39394480ke-sys/serialstride-legbot/assets/images/stm32f103-blue-pill-bench.jpg

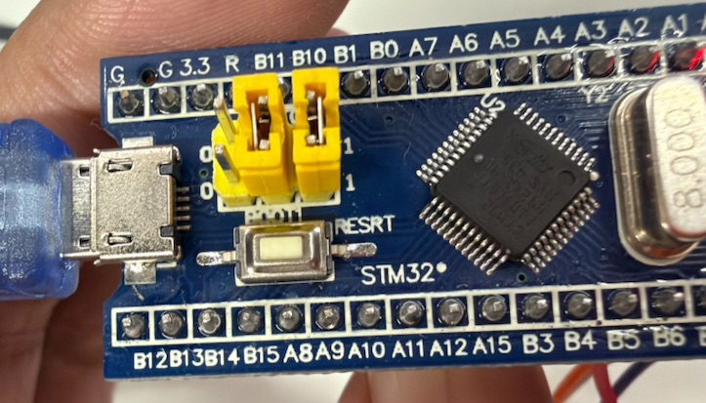
assets/images/stm32f103-blue-pill-bench.jpg
