39394480ke-sys/serialstride-legbot/项目记录/README.md

# 桌面级串联腿项目记录

这里保存桌面级串联腿底盘的阶段性结论、原始测试数据和可回退固件。
源代码只保存在 `../stm32f103_boot_test/`，本目录不复制源码。

## 当前状态

截至 2026-07-29，已完成一台 DM-H6215 的 STM32F103 临时台架验证：

- CAN 物理链路、1 Mbps 通信和双端 120 Ω 终端匹配正常。
- 参数读取、使能、失能、正反转和连续速度控制正常。
- 位置、速度、力矩、MOS 温度和线圈温度反馈解析正常。
- 速度斜坡、5 秒主机看门狗和异常自动失能正常。
- 当前可用固件已保存至 `固件快照/`。

## 目录

```text
项目记录/
├── README.md
├── 硬件接线与参数.md
├── 调试记录/
│   └── 2026-07-29_H6215单电机调通.md
├── 原始日志/
│   └── records-2026-07-29-21-30-49.json
└── 固件快照/
    ├── H6215_F103_连续速度控制_v1.bin
    └── SHA256SUMS
```

## 下一阶段

1. MC02 到货后迁移已经验证的 H6215 CAN 驱动和保护逻辑。
2. 增加第二台 H6215，设置不同 CAN ID，并验证左右轮同步和方向。
3. 完成 IMU 姿态读取和关节电机台架调试。
4. 在可靠支撑下测试 H6215 MIT 小力矩控制，为 LQR 平衡控制做准备。
