39394480ke-sys/serialstride-legbot/docs/progress/2026-08-14_MuJoCo三层模型职责重构.md

# 2026-08-14 MuJoCo 三层模型职责重构

## 阶段目标

固化整车 MuJoCo 模型中 CAD source、权威 geometry 与派生 dynamics 的职责
边界，避免后续动力学生成器重复创建或覆盖机构语义。

## 三层职责

| 模型 | 职责 | 状态 |
| --- | --- | --- |
| `robot_source.xml` | CAD 原始导出档案 | 内容未变化，SHA-256 已锁定 |
| `robot_geometry.xml` | 闭链、坐标、范围、传感器、模态接口和调试姿态 | 当前权威 geometry |
| `robot_dynamics.xml` | geometry 派生的质量与动力学模型 | 保留 Phase 1-3 快照，生成器待迁移 |

旧兼容入口 `robot.xml` 已删除。Phase 0 冻结记录继续保存在
`results/geometry_baseline.json`，当前权威记录为
`results/geometry_authority.json`。

## 验证结果

```text
robot_source.xml SHA-256:
9387924d3dad5ea2097e8953228b8de0cfd61661b36b10f039596c25b4e14d55

robot_geometry.xml SHA-256:
e7e1f21c22bbcc8846be8548e071819e72ccfad49df203704b56205417b800ea

robot_dynamics.xml SHA-256:
1bcb915f6203a42c6d35ebf9ee49d81685fd4969d9306a6783d7a1b5ae72ac21
```

权威 geometry 包含：

- 25 个 body；
- 24 个 joint；
- 6 个 equality connect；
- 4 个 fixed tendon；
- 4 个模态 position actuator；
- 11 个 keyframe。

11 个 keyframe 的最大闭链残差约为 `1.43e-9 m`。四个 rotation/shape
滑块的目标跟踪和左右腿隔离验证通过。用户已在 MuJoCo Viewer 中人工检查姿态
与滑块效果。

机械机构支持连续无限 360 度旋转，该能力已经由用户在实物机构上验证；
MuJoCo 全旋转扫描同时验证了数字模型的运动学与约束。

## 迁移保护

旧 `scripts/sync_inertials.py` 尚不理解新的模态 tendon、11 个 keyframe 和
气弹簧 slide 归一化。普通模式与 `--check` 均会在写文件前以
`MIGRATION REQUIRED` 停止，保护当前 dynamics 快照不被覆盖。

## 后续工作

- 迁移 geometry-to-dynamics 生成器；
- 恢复可重复的生成与一致性检查；
- 在 dynamics 中加入 6 个力矩电机、阻尼、摩擦、armature、气弹簧力、重力和场景；
- 后续验证地面接触、承重站立与控制算法。

## 验证命令

```sh
python3 simulation/mujoco/full_chassis/validate_model.py
python3 -m unittest discover \
  -s simulation/mujoco/full_chassis/scripts \
  -p 'test_*.py'
```
