39394480ke-sys/serialstride-legbot/docs/superpowers/plans/2026-08-08-dm-mc02-h6215-phase2.2a.md

# DM-MC02 + H6215 Phase 2.2a Implementation Plan

> **For agentic workers:** REQUIRED SUB-SKILL: Use superpowers:subagent-driven-development (recommended) or superpowers:executing-plans to implement this plan task-by-task. Steps use checkbox (`- [ ]`) syntax for tracking.

**Goal:** Add a USB CDC-triggered, one-shot `+0.2 rad/s` H6215 test that requires `A` then `G`, runs for 1000 ms, holds zero for 200 ms, and always finishes disabled.

**Architecture:** Keep CAN frame encoding, motion policy, and USB byte buffering in separate host-testable modules. `main.c` remains the hardware orchestrator: it converts feedback and CAN health into a safety snapshot, consumes USB commands, executes requested CAN actions, and emits logs. The first hardware session validates `S/A/X` without motion; only a later explicit user `G` starts the positive pulse.

**Tech Stack:** C11 host tests, STM32H723 HAL/FDCAN, ST USB Device CDC, CMake/Ninja, STM32CubeIDE GNU Arm toolchain, STM32CubeProgrammer CLI.

## Global Constraints

- Default state after reset or power-up is disabled; reset must never start motion.
- USB commands are single ASCII bytes, case-insensitive; CR and LF are ignored.
- `A` arms for exactly 10,000 ms and authorizes at most one `G`.
- `G` is the only Phase 2.2a motion trigger; `B` and continuous-speed commands remain unavailable.
- Target speed is fixed at `+0.200 rad/s` for 1000 ms, followed by `0 rad/s` for 200 ms and Disable.
- Speed commands are refreshed every 10 ms while running or holding zero.
- Start limits: fresh feedback within 500 ms, `STATE=DISABLED`, `MODE=3`, `|V|<0.1 rad/s`, both temperatures below 60 C, and CAN free of warning/passive/bus-off.
- Runtime limits: fresh feedback within 100 ms, `STATE=ENABLED`, `|V|<=0.8 rad/s`, both temperatures below 60 C, and CAN free of passive/bus-off.
- `X` always requests zero speed followed by Disable and clears Arm.
- No motor register writes, position commands, torque commands, DM4310 work, or GitHub push are part of this plan.

---

### Task 1: Encode the Guarded Motion CAN Frames

**Files:**
- Modify: `firmware/dm-mc02-can1-three-motor/app/h6215_protocol.h`
- Modify: `firmware/dm-mc02-can1-three-motor/app/h6215_protocol.c`
- Modify: `firmware/dm-mc02-can1-three-motor/tests/test_h6215_protocol.c`

**Interfaces:**
- Consumes: existing `H6215CanFrame`, `H6215_CAN_ID=1`.
- Produces: `bool h6215_build_enable_command(H6215CanFrame *frame)`, `bool h6215_build_positive_velocity_command(H6215CanFrame *frame)`, and `bool h6215_build_zero_velocity_command(H6215CanFrame *frame)`.

- [ ] **Step 1: Write failing frame-encoding tests**

Add tests asserting the exact verified protocol bytes:

```c
static void test_builds_enable_command(void)
{
    H6215CanFrame frame = {0};
    assert(h6215_build_enable_command(&frame));
    assert(frame.id == 1u && frame.dlc == 8u);
    for (uint8_t i = 0u; i < 7u; ++i) assert(frame.data[i] == 0xffu);
    assert(frame.data[7] == 0xfcu);
}

static void test_builds_phase22a_velocity_commands(void)
{
    H6215CanFrame frame = {0};
    assert(h6215_build_positive_velocity_command(&frame));
    assert(frame.id == 0x201u && frame.dlc == 4u);
    assert(frame.data[0] == 0xcdu && frame.data[1] == 0xccu);
    assert(frame.data[2] == 0x4cu && frame.data[3] == 0x3eu);

    assert(h6215_build_zero_velocity_command(&frame));
    assert(frame.id == 0x201u && frame.dlc == 4u);
    assert(frame.data[0] == 0u && frame.data[1] == 0u);
    assert(frame.data[2] == 0u && frame.data[3] == 0u);
}
```

- [ ] **Step 2: Run tests and verify RED**

Run: `cd firmware/dm-mc02-can1-three-motor && tests/run_tests.sh`

Expected: linker failure for the three missing `h6215_build_*` functions.

- [ ] **Step 3: Implement only the three fixed commands**

Use a private helper for the two system frames and fixed IEEE-754 bytes for `+0.2f`. Zero every unused data byte even though the velocity DLC is 4.

```c
static bool build_system_command(uint8_t opcode, H6215CanFrame *frame);

bool h6215_build_enable_command(H6215CanFrame *frame)
{
    return build_system_command(0xfcu, frame);
}

bool h6215_build_positive_velocity_command(H6215CanFrame *frame)
{
    static const uint8_t value[4] = {0xcdu, 0xccu, 0x4cu, 0x3eu};
    /* CAN ID 0x200 + motor ID 1, classic CAN, four-byte payload. */
}
```

- [ ] **Step 4: Run all host tests and verify GREEN**

Run: `tests/run_tests.sh`

Expected: exit 0 with no warnings.

- [ ] **Step 5: Commit the protocol change**

```bash
git add firmware/dm-mc02-can1-three-motor/app/h6215_protocol.* \
        firmware/dm-mc02-can1-three-motor/tests/test_h6215_protocol.c
git commit -m "feat: encode guarded H6215 motion frames"
```

---

### Task 2: Build a Pure Guarded Motion State Machine

**Files:**
- Create: `firmware/dm-mc02-can1-three-motor/app/motion_controller.h`
- Create: `firmware/dm-mc02-can1-three-motor/app/motion_controller.c`
- Create: `firmware/dm-mc02-can1-three-motor/tests/test_motion_controller.c`
- Modify: `firmware/dm-mc02-can1-three-motor/tests/run_tests.sh`

**Interfaces:**
- Consumes: a caller-provided `MotionSafetySnapshot`; no HAL, USB, or FDCAN headers.
- Produces:

```c
typedef enum {
    MOTION_IDLE_DISABLED,
    MOTION_ARMED,
    MOTION_ENABLE_WAIT,
    MOTION_RUNNING,
    MOTION_ZERO_HOLD,
    MOTION_FAULT_ZERO,
    MOTION_FAULT_DISABLE
} MotionState;

typedef enum {
    MOTION_ACTION_NONE,
    MOTION_ACTION_ENABLE,
    MOTION_ACTION_POSITIVE_VELOCITY,
    MOTION_ACTION_ZERO_VELOCITY,
    MOTION_ACTION_DISABLE
} MotionAction;

typedef enum {
    MOTION_EVENT_NONE,
    MOTION_EVENT_STATUS,
    MOTION_EVENT_ARMED,
    MOTION_EVENT_ARM_TIMEOUT,
    MOTION_EVENT_START_REJECTED,
    MOTION_EVENT_START_REQUESTED,
    MOTION_EVENT_RUNNING,
    MOTION_EVENT_ZERO_HOLD,
    MOTION_EVENT_COMPLETE,
    MOTION_EVENT_EMERGENCY_STOP,
    MOTION_EVENT_SAFETY_TRIP,
    MOTION_EVENT_TX_FAILURE
} MotionEvent;

typedef struct {
    uint32_t now_ms;
    uint32_t feedback_age_ms;
    uint8_t parameter_mask;
    uint8_t control_mode;
    uint8_t motor_state;
    int32_t velocity_millirad_s;
    uint8_t mos_temperature_c;
    uint8_t rotor_temperature_c;
    bool feedback_valid;
    bool can_warning;
    bool can_passive;
    bool can_bus_off;
} MotionSafetySnapshot;

typedef struct {
    MotionAction action;
    MotionEvent event;
    const char *reason;
} MotionDecision;

typedef struct {
    MotionState state;
    bool armed;
    uint32_t armed_at_ms;
    uint32_t phase_started_ms;
    uint32_t last_action_ms;
} MotionController;

void motion_controller_init(MotionController *controller);
MotionDecision motion_controller_command(MotionController *controller,
                                          uint8_t command,
                                          const MotionSafetySnapshot *safety);
MotionDecision motion_controller_step(MotionController *controller,
                                       const MotionSafetySnapshot *safety);
MotionDecision motion_controller_tx_failed(MotionController *controller);
```

- [ ] **Step 1: Write failing tests for command gating**

Cover lowercase/uppercase, ignored CR/LF, `G` without Arm, Arm validity at 9,999 ms and timeout at 10,000 ms, one-shot Arm consumption, unsafe mode/state/speed/temperature/CAN rejection, and `X` from every state. Representative assertion:

```c
MotionSafetySnapshot safe = safe_disabled_snapshot(1000u);
MotionController controller;
motion_controller_init(&controller);

MotionDecision arm = motion_controller_command(&controller, 'A', &safe);
assert(arm.event == MOTION_EVENT_ARMED);
MotionDecision start = motion_controller_command(&controller, 'g', &safe);
assert(start.action == MOTION_ACTION_ENABLE);
assert(controller.state == MOTION_ENABLE_WAIT);
assert(!controller.armed);
```

- [ ] **Step 2: Run the dedicated test and verify RED**

Add a third compiler invocation to `tests/run_tests.sh`, then run it.

Expected: compile failure because `motion_controller.h` and implementation do not exist.

- [ ] **Step 3: Implement command normalization and start checks**

Implement `S/A/G/X`, ignore `\r` and `\n`, and return a stable reason string such as `SEND_A_FIRST`, `MODE_NOT_VELOCITY`, `FEEDBACK_STALE`, `STATE_NOT_DISABLED`, `SPEED_NOT_ZERO`, `TEMPERATURE_LIMIT`, or `CAN_NOT_ACTIVE`.

- [ ] **Step 4: Run tests and verify command gating GREEN**

Run: `tests/run_tests.sh`

Expected: all existing and new gating tests pass.

- [ ] **Step 5: Write failing timeline and safety-trip tests**

Drive synthetic timestamps through this exact sequence:

```text
t=0       A then G -> ENABLE
t=100     feedback ENABLED -> +0.2 command and RUNNING
t=110..1090 every 10 ms -> +0.2 refresh
t=1100    -> zero command and ZERO_HOLD
t=1110..1290 every 10 ms -> zero refresh
t=1300    -> Disable and IDLE_DISABLED
```

Also assert feedback age 101 ms, speed 801 mrad/s, temperature 60 C, state change away from ENABLED, CAN passive, CAN bus-off, and transmit failure all enter zero-then-disable shutdown.

- [ ] **Step 6: Run timeline tests and verify RED**

Expected: failures because `motion_controller_step` does not yet implement timed transitions and trips.

- [ ] **Step 7: Implement timed transitions and fault shutdown**

Use unsigned tick subtraction for wraparound. `MOTION_FAULT_ZERO` must return one zero action, then `MOTION_FAULT_DISABLE` must return Disable on the next 1 ms step. Do not add negative or continuous states.

- [ ] **Step 8: Run all tests and verify GREEN**

Run: `tests/run_tests.sh`

Expected: all tests pass with `-Wall -Wextra -Werror`.

- [ ] **Step 9: Commit the state machine**

```bash
git add firmware/dm-mc02-can1-three-motor/app/motion_controller.* \
        firmware/dm-mc02-can1-three-motor/tests/test_motion_controller.c \
        firmware/dm-mc02-can1-three-motor/tests/run_tests.sh
git commit -m "feat: add guarded positive motion state machine"
```

---

### Task 3: Add a Nonblocking USB CDC Command Queue

**Files:**
- Create: `firmware/dm-mc02-can1-three-motor/app/usb_command_queue.h`
- Create: `firmware/dm-mc02-can1-three-motor/app/usb_command_queue.c`
- Create: `firmware/dm-mc02-can1-three-motor/tests/test_usb_command_queue.c`
- Modify: `firmware/dm-mc02-can1-three-motor/tests/run_tests.sh`
- Modify: `firmware/dm-mc02-can1-three-motor/CMakeLists.txt`
- Modify: `firmware/dm-mc02-can1-three-motor/platform/usb_device/App/usbd_cdc_if.c:24-35,264-270`
- Modify: `firmware/dm-mc02-can1-three-motor/platform/usb_device/App/usbd_cdc_if.h:32-55,108-112`

**Interfaces:**
- Consumes: byte spans received by `CDC_Receive_HS`.
- Produces:

```c
void usb_command_queue_init(void);
void usb_command_queue_push_from_isr(const uint8_t *data, uint32_t length);
bool usb_command_queue_pop(uint8_t *command);
uint32_t usb_command_queue_dropped(void);
```

- [ ] **Step 1: Write failing SPSC queue tests**

Test FIFO order, a packet containing `"A\r\nG"`, wraparound, null arguments, and deterministic drop-newest behavior when the fixed 32-byte queue is full.

- [ ] **Step 2: Run tests and verify RED**

Expected: missing header/implementation failure.

- [ ] **Step 3: Implement the 32-byte single-producer/single-consumer queue**

Use volatile byte indices. The USB callback is the only producer and the 1 ms main loop is the only consumer. Do not allocate memory, print, parse commands, or touch CAN inside the callback.

- [ ] **Step 4: Run queue tests and verify GREEN**

Run: `tests/run_tests.sh`

Expected: all tests pass.

- [ ] **Step 5: Wire only byte ingestion into `CDC_Receive_HS`**

The callback body must remain bounded:

```c
usb_command_queue_push_from_isr(Buf, *Len);
USBD_CDC_SetRxBuffer(&hUsbDeviceHS, &Buf[0]);
USBD_CDC_ReceivePacket(&hUsbDeviceHS);
return USBD_OK;
```

- [ ] **Step 6: Cross-compile the firmware**

Add `app/usb_command_queue.c` to `add_executable`, then run from the firmware directory:

```bash
cmake -S . -B build-phase22a -G Ninja
cmake --build build-phase22a
```

Expected: successful link with no warnings.

- [ ] **Step 7: Commit the USB queue**

```bash
git add firmware/dm-mc02-can1-three-motor/app/usb_command_queue.* \
        firmware/dm-mc02-can1-three-motor/tests/test_usb_command_queue.c \
        firmware/dm-mc02-can1-three-motor/tests/run_tests.sh \
        firmware/dm-mc02-can1-three-motor/CMakeLists.txt \
        firmware/dm-mc02-can1-three-motor/platform/usb_device/App/usbd_cdc_if.*
git commit -m "feat: receive guarded commands over USB CDC"
```

---

### Task 4: Integrate Motion Without Expanding `main.c` Policy

**Files:**
- Modify: `firmware/dm-mc02-can1-three-motor/app/main.c`
- Modify: `firmware/dm-mc02-can1-three-motor/CMakeLists.txt`
- Modify: `firmware/dm-mc02-can1-three-motor/platform/src/board.c:148-168`
- Modify: `firmware/dm-mc02-can1-three-motor/README.md`

**Interfaces:**
- Consumes: `usb_command_queue_pop`, `MotionSafetySnapshot`, `MotionDecision`, and the four H6215 action builders.
- Produces: hardware execution and the exact user-visible transition logs from the design.

- [ ] **Step 1: Add new modules to CMake and create a clean build directory**

Run:

```bash
cmake -S firmware/dm-mc02-can1-three-motor \
      -B firmware/dm-mc02-can1-three-motor/build-phase22a -G Ninja
```

Add `app/motion_controller.c` to `add_executable`; Task 3 already added `app/usb_command_queue.c`.

- [ ] **Step 2: Build the hardware safety snapshot in `main.c`**

Map the current `WheelStatus` and `Can1Status` into `MotionSafetySnapshot` once per 1 ms iteration. Feedback age must use the last actual feedback timestamp, not the last parameter response timestamp; split `last_rx_ms` into `last_any_rx_ms` and `last_feedback_ms`.

- [ ] **Step 3: Permit the approved four-byte classic CAN payload**

Update `board_can1_transmit` to accept only DLC 4 or 8 and map them explicitly:

```c
if (dlc == 4u) {
    header.DataLength = FDCAN_DLC_BYTES_4;
} else if (dlc == 8u) {
    header.DataLength = FDCAN_DLC_BYTES_8;
} else {
    return false;
}
```

Retain the existing standard-ID, null-pointer, FIFO-space, classic-CAN, and no-BRS checks. This is required because the H6215 velocity command has DLC 4 while the parameter/system frames have DLC 8.

- [ ] **Step 4: Add one action executor**

```c
static bool execute_motion_action(MotionAction action, WheelStatus *wheel)
{
    H6215CanFrame frame;
    /* Select exactly one approved builder, then call board_can1_transmit. */
}
```

On failure, immediately feed `motion_controller_tx_failed` back into the controller and execute its zero/Disable recovery sequence. Count every attempted result in `tx_ok` or `tx_failed`.

- [ ] **Step 5: Consume commands and step motion in the 1 ms loop**

Drain at most 32 queued bytes per loop. Process `X` before scheduled motion actions when both occur in the same millisecond. Parameter polling may continue while idle, but pause register polling during `ENABLE_WAIT`, `RUNNING`, `ZERO_HOLD`, and fault shutdown so it cannot contend with 10 ms control frames.

- [ ] **Step 6: Add nonblocking event logs**

Map events/actions to the design's exact stable strings: `MOTION_ARMED EXPIRES_MS=10000`, `MOTION_START_REQUESTED TARGET=+0.200rad/s`, `MOTOR_ENABLE_TX_OK`, `MOTION_RUNNING TARGET=+0.200rad/s DURATION_MS=1000`, `ZERO_SPEED_HOLD DURATION_MS=200`, and `TEST_COMPLETE MOTOR_DISABLED`. Rejections and trips append `REASON=<stable reason>`. Use static double buffers with `CDC_Transmit_HS`; a busy CDC endpoint increments `dropped_logs` and never blocks motion. During non-idle motion states, emit `[WHEEL]` every 100 ms; otherwise retain the 1000 ms rate.

- [ ] **Step 7: Update the boot banner and README**

Boot text must state:

```text
H6215_GUARDED_MOTION COMMANDS=S,A,G,X TARGET=+0.200rad/s
DEFAULT_STATE=DISABLED AUTO_MOTION=OFF
```

Document the exact serial.baud-dance.com settings and warn that `G` without a fresh `A` is rejected.

- [ ] **Step 8: Run host tests, clean build, and source audit**

Run:

```bash
tests/run_tests.sh
cmake --build build-phase22a
rg -n -- "-0\.2|MOTION_CONTINUOUS|0x300u|torque.*command" app platform
git diff --check
```

Expected: tests/build/diff pass; the audit finds no negative, continuous, force-position, or torque command implementation.

- [ ] **Step 9: Commit integration**

```bash
git add firmware/dm-mc02-can1-three-motor/app/main.c \
        firmware/dm-mc02-can1-three-motor/CMakeLists.txt \
        firmware/dm-mc02-can1-three-motor/platform/src/board.c \
        firmware/dm-mc02-can1-three-motor/README.md
git commit -m "feat: integrate guarded H6215 USB motion test"
```

---

### Task 5: Flash and Validate Commands Without Motion

**Files:**
- Generated only: `firmware/dm-mc02-can1-three-motor/build-phase22a/dm_mc02_phase1.bin`
- Evidence later written by Task 6; do not modify source during this checkpoint.

**Interfaces:**
- Consumes: ST-Link, powered MC02, connected H6215, USB CDC.
- Produces: proof that boot, `S`, `A` timeout, rejected `G`, and `X` remain non-moving and disabled.

- [ ] **Step 1: Reconfirm physical setup**

Require fixed stator, unobstructed rotor, 24 V cutoff within reach, CAN still connected, and serial tool automatic/loop sending disabled.

- [ ] **Step 2: Flash and verify**

Use STM32CubeProgrammer CLI with SWD under-reset connection, write the binary to `0x08000000`, enable verify, and reset. Record the binary SHA-256.

- [ ] **Step 3: Capture boot and idle state**

Require all boot markers, `[WHEEL] ONLINE=1`, `STATE=DISABLED`, `MODE=3`, `TEC=REC=0`, and `missed=0` before accepting commands.

- [ ] **Step 4: Verify `G` is rejected without Arm**

Send ASCII `G`. Require `START_REJECTED REASON=SEND_A_FIRST`, no Enable log, and continued `STATE=DISABLED`.

- [ ] **Step 5: Verify Arm timeout**

Send `A`; require `MOTION_ARMED EXPIRES_MS=10000`. Wait over 10 seconds; require `ARM_TIMEOUT`, then send `G` and require rejection with no movement.

- [ ] **Step 6: Verify `X` while idle**

Send `X`; require `EMERGENCY_STOP_REQUESTED`, a zero/Disable sequence, fresh `STATE=DISABLED` feedback, and no CAN errors.

- [ ] **Step 7: Stop at the human gate**

Report the idle-command evidence. Do not send `A` followed by `G`; the user must explicitly confirm readiness for the real positive test.

---

### Task 6: Execute and Archive the User-Triggered Positive Test

**Files:**
- Modify: `docs/bring-up/dm-mc02/README.md`
- Create: `docs/bring-up/dm-mc02/logs/phase2.2a-h6215-positive-2026-08-08.log.gz`
- Create: `docs/bring-up/dm-mc02/logs/phase2.2a-h6215-positive-2026-08-08.json`

**Interfaces:**
- Consumes: the user operating serial.baud-dance.com and the firmware from Task 5.
- Produces: reproducible evidence or a precise failed/aborted result without proceeding to negative motion.

- [ ] **Step 1: Give the user exact serial-tool settings**

Repeat `115200, 8 data bits, None parity, 1 stop bit, ASCII send/receive, HEX off, loop/automatic send off`. Select `STM32 Virtual ComPort (cu.usbmodem...)`.

- [ ] **Step 2: Capture the browser log and perform the human-triggered sequence**

Do not open the same USB serial port from a terminal while `serial.baud-dance.com` owns it. The user clears the browser receive pane, sends `S`, confirms safe idle output, sends `A`, waits for `MOTION_ARMED`, then sends `G`, and exports the browser's raw receive log after the observation window. Keep the 24 V cutoff within reach and use it immediately for unexpected direction, sustained motion beyond about one second, unusual sound, or mechanical interference.

- [ ] **Step 3: Validate automatic completion**

Require `MOTION_RUNNING`, `ZERO_SPEED_HOLD`, and `TEST_COMPLETE MOTOR_DISABLED`. Continue observing at least five seconds; require `STATE=DISABLED`, near-zero velocity, temperatures below 60 C, `TEC=REC=0`, no passive/bus-off, and `missed=0`.

- [ ] **Step 4: Compare observed behavior with logs**

Record the user's explicit direction observation separately from firmware facts. Compute minimum/maximum feedback velocity, position delta, torque range, temperature maxima, motion duration, and final CAN state from the captured log.

- [ ] **Step 5: Archive evidence and update documentation**

The JSON must distinguish verified telemetry, user-observed direction, inference, and unverified items. Compress the raw log with deterministic `gzip -n`, record raw log and firmware SHA-256, and state that negative/continuous motion remain unverified.

- [ ] **Step 6: Final verification without entering Phase 2.2b**

Run host tests, rebuild cleanly, validate JSON, test gzip integrity, run `git diff --check`, and sample current live `STATE=DISABLED`/CAN health. Do not add or execute `B` until the positive-test evidence has been reviewed.
