39394480ke-sys/serialstride-legbot/simulation/mujoco/full_chassis/meshes/link_004.stl

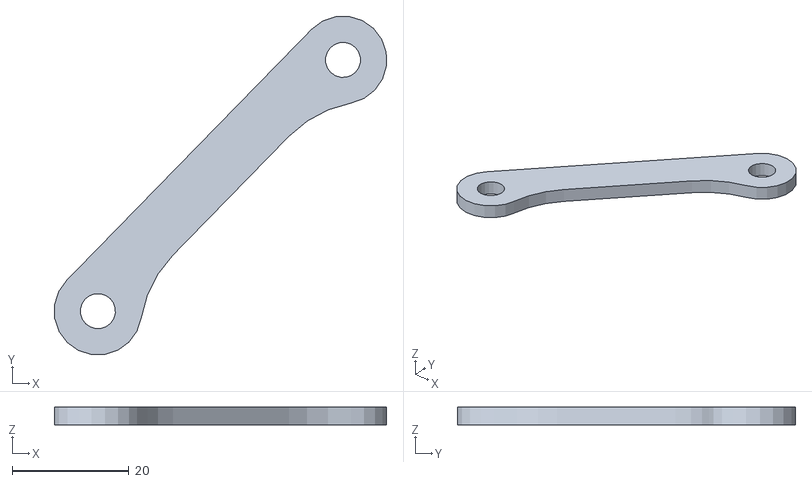
[picture p2: CAD file, 2026-08-13]
simulation/mujoco/full_chassis/meshes/link_004.stl
56.8 x 57.8 x 3.00
