39394480ke-sys/serialstride-legbot/simulation/mujoco/full_chassis/meshes/link_003.stl

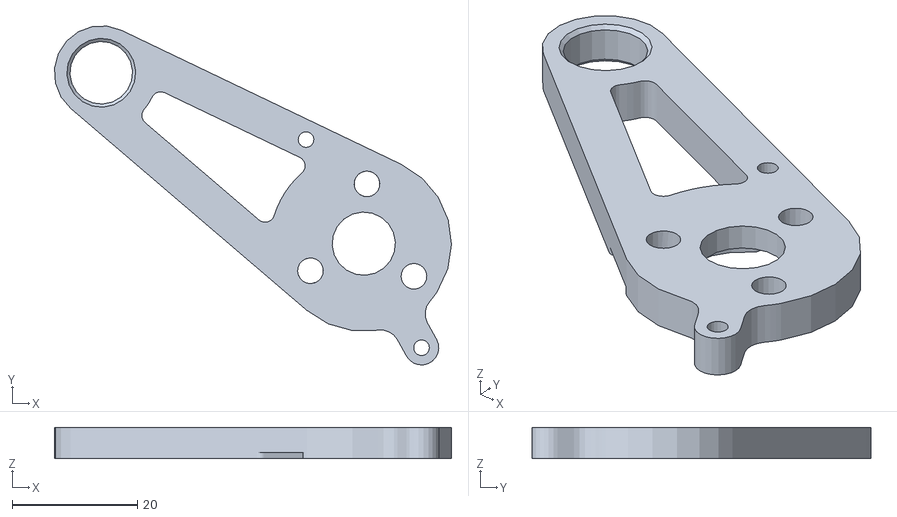
[picture p3: CAD file, 2026-08-13]
simulation/mujoco/full_chassis/meshes/link_003.stl
63.4 x 54.1 x 5.00
