39394480ke-sys/serialstride-legbot/simulation/mujoco/full_chassis/meshes/link_006.stl

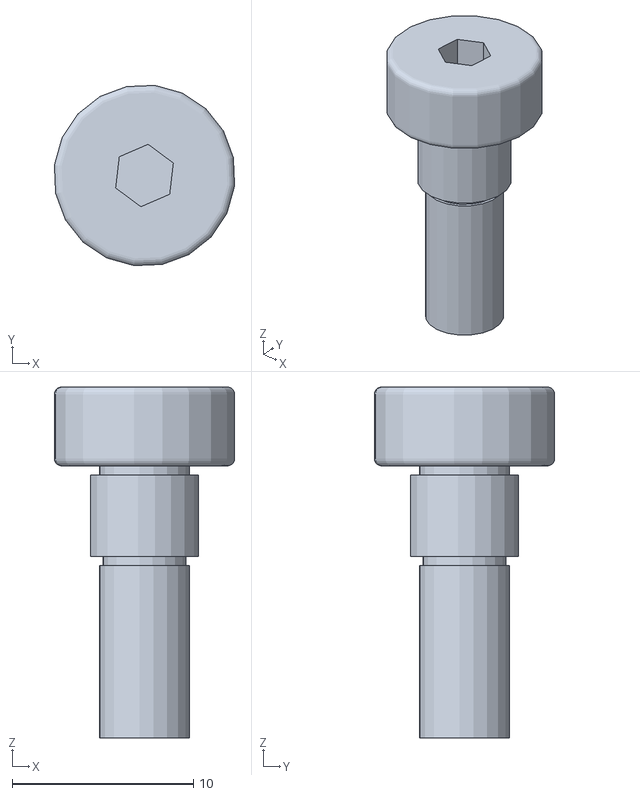
[picture p4: CAD file, 2026-08-13]
simulation/mujoco/full_chassis/meshes/link_006.stl
9.93 x 9.93 x 19.3
