39394480ke-sys/serialstride-legbot/simulation/mujoco/full_chassis/meshes/link_017.stl

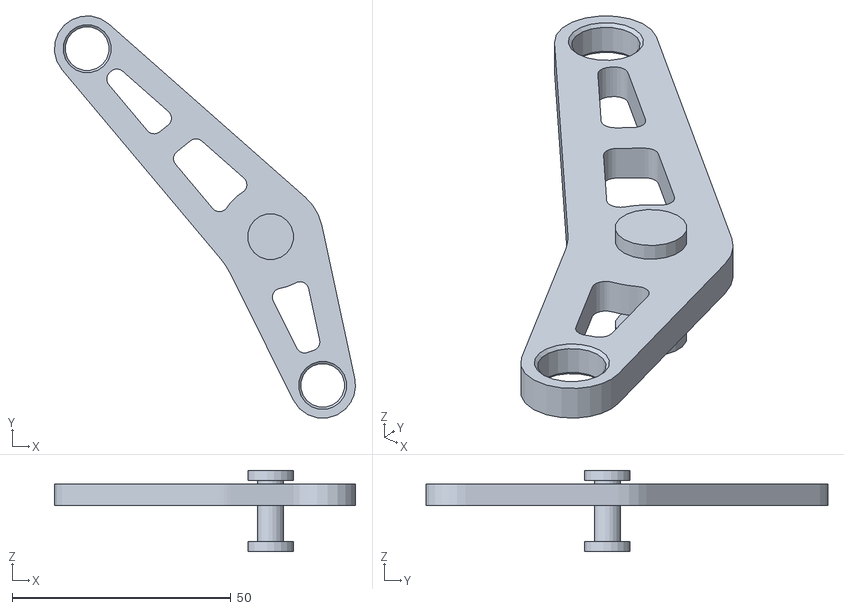
[picture p5: CAD file, 2026-08-13]
simulation/mujoco/full_chassis/meshes/link_017.stl
68.8 x 91.8 x 18.6
