39394480ke-sys/serialstride-legbot/simulation/mujoco/full_chassis/meshes/link_022.stl

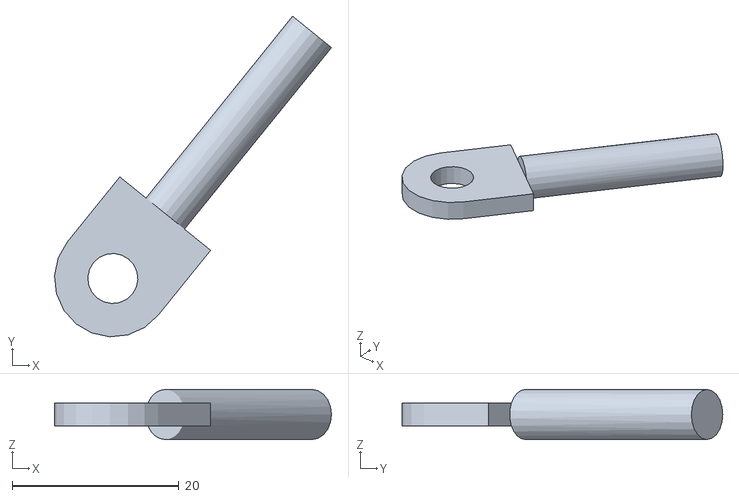
[picture p6: CAD file, 2026-08-13]
simulation/mujoco/full_chassis/meshes/link_022.stl
33.2 x 38.4 x 6.00
