39394480ke-sys/serialstride-legbot/simulation/mujoco/full_chassis/meshes/link_009.stl

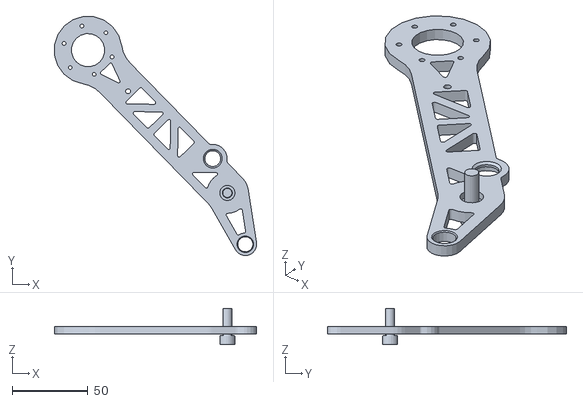
[picture p7: CAD file, 2026-08-13]
simulation/mujoco/full_chassis/meshes/link_009.stl
133.7 x 158.2 x 24.0
