39394480ke-sys/serialstride-legbot/simulation/mujoco/full_chassis/meshes/link_019.stl

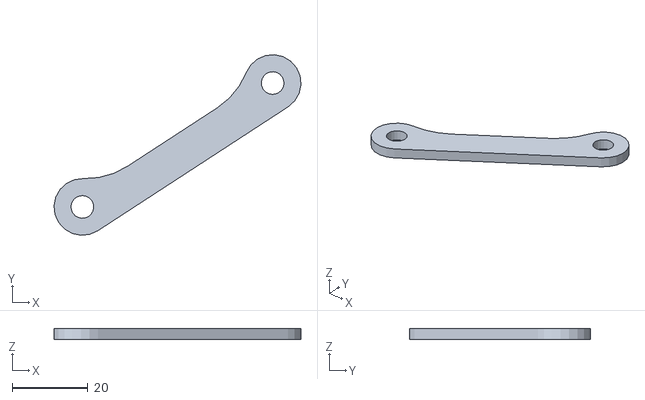
[picture p8: CAD file, 2026-08-13]
simulation/mujoco/full_chassis/meshes/link_019.stl
65.3 x 47.7 x 3.00
