39394480ke-sys/serialstride-legbot/simulation/mujoco/full_chassis/meshes/link_012.stl

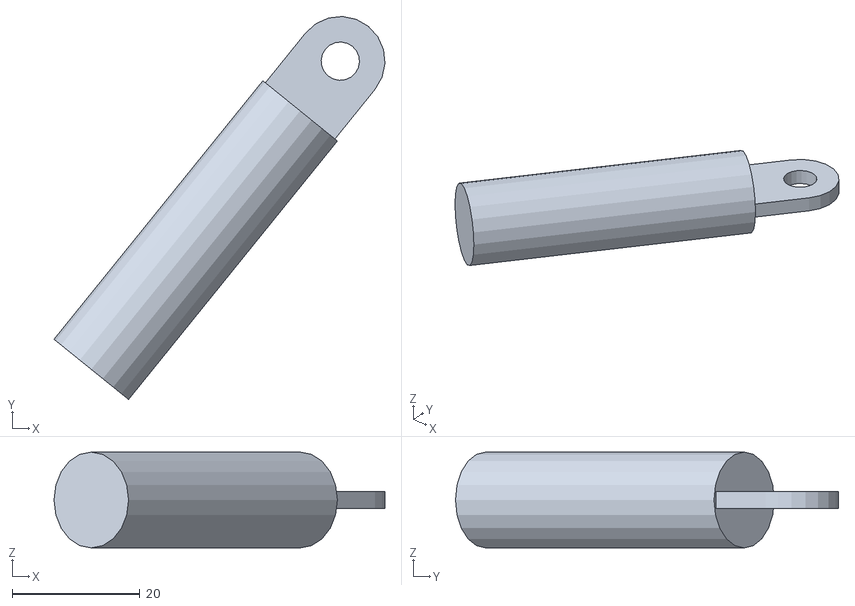
[picture p9: CAD file, 2026-08-13]
simulation/mujoco/full_chassis/meshes/link_012.stl
51.8 x 59.9 x 15.0
