39394480ke-sys/serialstride-legbot/simulation/mujoco/full_chassis/meshes/link_002.stl

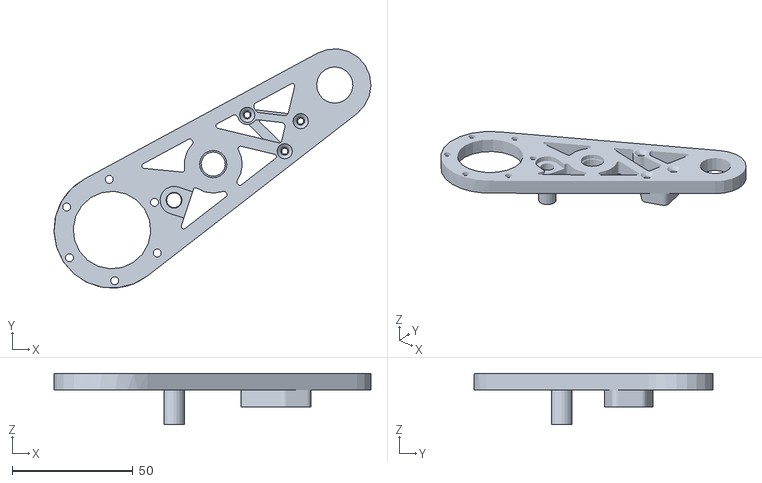
[picture p10: CAD file, 2026-08-13]
simulation/mujoco/full_chassis/meshes/link_002.stl
131.2 x 98.9 x 21.3
