39394480ke-sys/serialstride-legbot/simulation/mujoco/full_chassis/meshes/link_025.stl

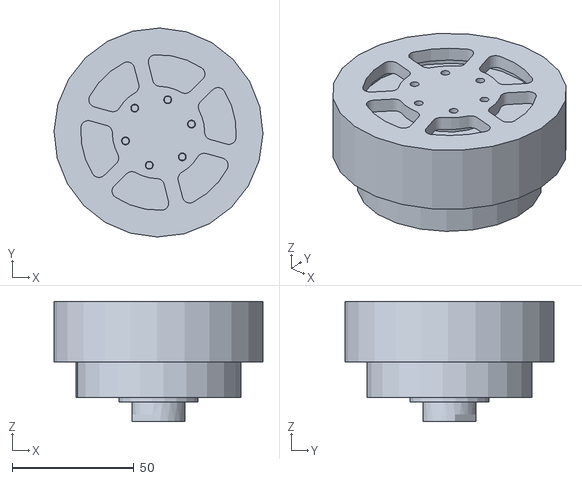
[picture p11: CAD file, 2026-08-13]
simulation/mujoco/full_chassis/meshes/link_025.stl
86.0 x 86.0 x 49.5
