39394480ke-sys/serialstride-legbot/simulation/mujoco/full_chassis/meshes/link_008.stl

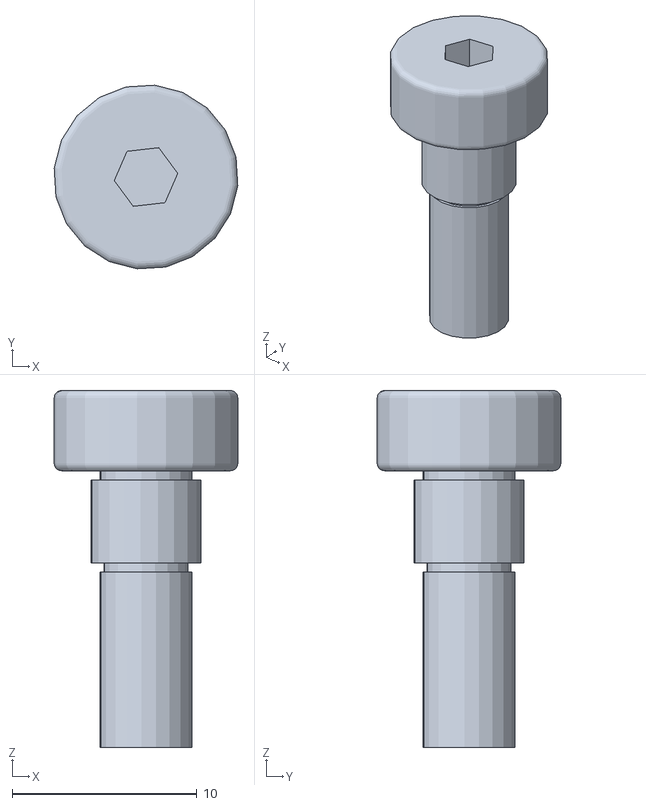
[picture p12: CAD file, 2026-08-13]
simulation/mujoco/full_chassis/meshes/link_008.stl
9.95 x 9.95 x 19.3
