39394480ke-sys/serialstride-legbot/simulation/mujoco/full_chassis/meshes/link_013.stl

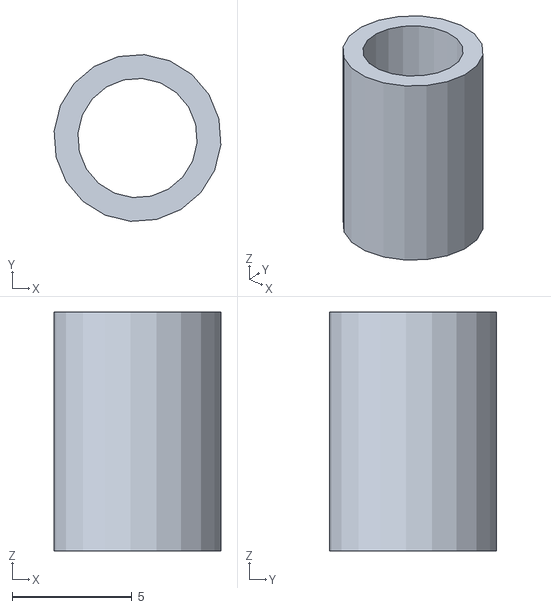
[picture p13: CAD file, 2026-08-13]
simulation/mujoco/full_chassis/meshes/link_013.stl
6.98 x 6.98 x 10.0
