39394480ke-sys/serialstride-legbot/simulation/mujoco/full_chassis/meshes/base_link.stl

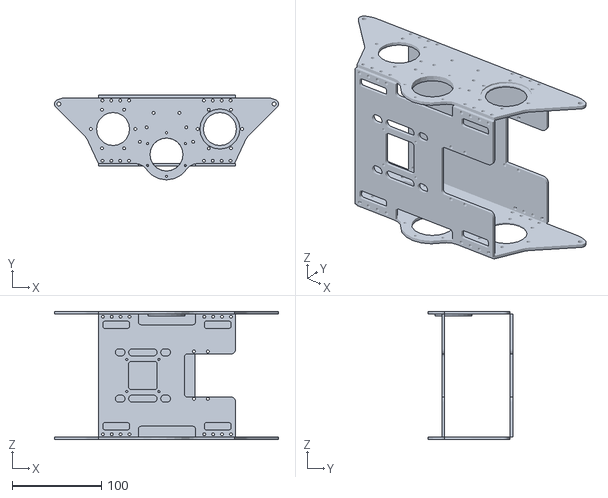
[picture p14: CAD file, 2026-08-13]
simulation/mujoco/full_chassis/meshes/base_link.stl
251.6 x 95.3 x 144.0
