39394480ke-sys/serialstride-legbot/(list of files, cad)

Other CAD files:
simulation/mujoco/full_chassis/meshes/link_016.stl
simulation/mujoco/full_chassis/meshes/link_011.stl
simulation/mujoco/full_chassis/meshes/link_020.stl
simulation/mujoco/full_chassis/meshes/link_005.stl
simulation/mujoco/full_chassis/meshes/link_007.stl
simulation/mujoco/full_chassis/meshes/link_023.stl
simulation/mujoco/full_chassis/meshes/link_010.stl
simulation/mujoco/full_chassis/meshes/link_018.stl
simulation/mujoco/full_chassis/meshes/link_024.stl
simulation/mujoco/full_chassis/meshes/link_015.stl
simulation/mujoco/full_chassis/meshes/link_014.stl
simulation/mujoco/full_chassis/meshes/link_021.stl
