39394480ke-sys/serialstride-legbot/docs/bring-up/h6215-single-motor/README.md

# DM-H6215 单电机 Bring-up

这里保存 DM-H6215 单电机台架的阶段性结论和原始测试数据。源代码只保存在
[`firmware/stm32f103-h6215-bench/`](../../../firmware/stm32f103-h6215-bench/)，
本目录不复制源码。已验证二进制通过 GitHub Release 发布。

## 当前状态

截至 2026-07-29，已完成一台 DM-H6215 的 STM32F103 临时台架验证：

- CAN 物理链路、1 Mbps 通信和双端 120 Ω 终端匹配正常。
- 参数读取、使能、失能、正反转和连续速度控制正常。
- 位置、速度、力矩、MOS 温度和线圈温度反馈解析正常。
- 速度斜坡、5 秒主机看门狗和异常自动失能正常。
- 当前可用固件对应 `v0.1.0` GitHub Release。

## 目录

```text
docs/bring-up/h6215-single-motor/
├── README.md
├── 硬件接线与参数.md
└── logs/
    └── records-2026-07-29-21-30-49.json
```

完整过程见
[`docs/progress/2026-07-29_H6215单电机调通.md`](../../progress/2026-07-29_H6215单电机调通.md)。

## 下一阶段

1. MC02 到货后迁移已经验证的 H6215 CAN 驱动和保护逻辑。
2. 增加第二台 H6215，设置不同 CAN ID，并验证左右轮同步和方向。
3. 完成 IMU 姿态读取和关节电机台架调试。
4. 在可靠支撑下测试 H6215 MIT 小力矩控制，为 LQR 平衡控制做准备。
