39394480ke-sys/serialstride-legbot/docs/progress/2026-08-10_单腿机械Bring-up.md

# 2026-08-10 单腿机械 Bring-up

## 阶段目标

将 MC02 CAN1 单侧三电机网络装入真实单腿机构，完成方向识别、
软件标定、安全限位和悬空低速双关节协同。

## 结论

本 Stage 按修订后的验收条件完成。

| 项目 | 结果 |
| --- | --- |
| CAN1 | 1 Mbps |
| JOINT_A | DM4310, `CAN_ID=6`, `MST_ID=3`, MIT |
| JOINT_B | DM4310, `CAN_ID=8`, `MST_ID=4`, MIT |
| WHEEL | H6215, `CAN_ID=1`, `MST_ID=0`, Velocity |
| 机械伸腿正方向 | A=`+1`, B=`-1` |
| CROUCH 机械极限 | A=`+0.662`, B=`-0.951 rad` |
| EXTEND 机械极限 | A=`+1.354`, B=`-1.662 rad` |
| 临时 STAND | A=`+1.008`, B=`-1.307 rad` |
| A 软件范围 | `+0.731..+1.285 rad` |
| B 软件范围 | `-1.591..-1.022 rad` |
| MID_CROUCH | A=`+0.835`, B=`-1.129 rad` |
| MID_EXTEND | A=`+1.181`, B=`-1.484 rad` |

完整悬空协同序列通过，运动方向正确、平滑且无异响。WHEEL 全程
Disabled，未观察到 CAN 失控或安全中止。MCU 重启默认失能，
`STOP ALL`、显式 ARM、超时、反馈新鲜度、限位和故障保护均保留。

24 V 上下电重复读数：

```text
R0: JOINT_A=+1.054 rad, JOINT_B=-1.367 rad
R1: JOINT_A=+1.054 rad, JOINT_B=-1.367 rad
```

## 定义边界

- `CROUCH` 和 `EXTEND` 是机械接触极限，不是可指令目标。
- `STAND` 只是两个机械端点的算术中点，尚不是承重姿态。
- `MID_CROUCH` 和 `MID_EXTEND` 是本次悬空低速验证的安全目标。
- 低增益控制有约 `0.04..0.07 rad` 的最终跟踪残差。
- 一次 Disable 瞬间出现 JOINT_B `+0.212 rad/s`，下一帧恢复，原因未确认。

## 已接受的验收豁免

- 未进行 3 次机械重复标定。
- 未进行连续 10 次协同循环。
- 未验证长期耐久、承重、稳定性和正运动学。

## 证据与隐私

详细标定见
[`2026-08-10-single-leg-phase7-phase8.md`](../../firmware/dm-mc02-can1-three-motor/evidence/2026-08-10-single-leg-phase7-phase8.md)。
原始照片包含桌面、屏幕和购买信息，本次不公开。没有可用的完整脱敏串口
导出，因此仓库只保存经确认的工程结论，不伪造原始日志。
