39394480ke-sys/serialstride-legbot/simulation/mujoco/full_chassis/results/joint_scan.csv

side | q_a_command_rad | q_b_command_rad | wheel_hx_m | wheel_hz_m | other_wheel_hx_m | other_wheel_hz_m | gas_slide_q_m | max_abs_qvel | max_abs_equality_residual_m | q_link_005_joint_rad | q_link_006_joint_rad | q_link_007_joint_rad | q_link_008_joint_rad | q_link_009_joint_rad | q_link_011_joint_rad | q_link_013_joint_rad | q_link_004_joint_rad | q_link_017_joint_rad | q_link_019_joint_rad | q_link_021_joint_rad | q_link_020_joint_rad | q_link_022_joint_rad | q_link_024_joint_rad | q_link_016_joint_rad | q_link_018_joint_rad
left | -0.277 | -0.285 | 0.000372301344983932 | -0.0930727828898117 | 1.72028744174643e-09 | -0.134300206915378 | -0.02117357644575 | 1.19762019932973e-06 | 1.19238058315929e-09 | -0.605428630975238 | -7.40027838486895e-14 | 0.605428641430617 | -2.1173874071757e-13 | -0.605428647111721 | -0.0358274444079535 | -5.09644519907815e-10 | 0.605428631011852
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
