39394480ke-sys/serialstride-legbot/simulation/mujoco/full_chassis/results/modal_scan.csv

side | target_rotation_rad | target_shape_rad | q_a_command_rad | q_b_command_rad | actual_rotation_rad | actual_shape_rad | rotation_tracking_error_rad | shape_tracking_error_rad | wheel_hx_m | wheel_hz_m | wheel_radius_m | wheel_angle_rad | other_wheel_hx_m | other_wheel_hz_m | gas_slide_q_m | max_abs_nonwheel_qvel | max_abs_equality_residual_m | q_link_005_joint_rad | q_link_006_joint_rad | q_link_007_joint_rad | q_link_008_joint_rad | q_link_009_joint_rad | q_link_011_joint_rad | q_link_013_joint_rad | q_link_004_joint_rad | q_link_017_joint_rad | q_link_019_joint_rad | q_link_021_joint_rad | q_link_020_joint_rad | q_link_022_joint_rad | q_link_024_joint_rad | q_link_016_joint_rad | q_link_018_joint_rad
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
