39394480ke-sys/serialstride-legbot/simulation/kinematics/single_leg/results/leg_length_range.png

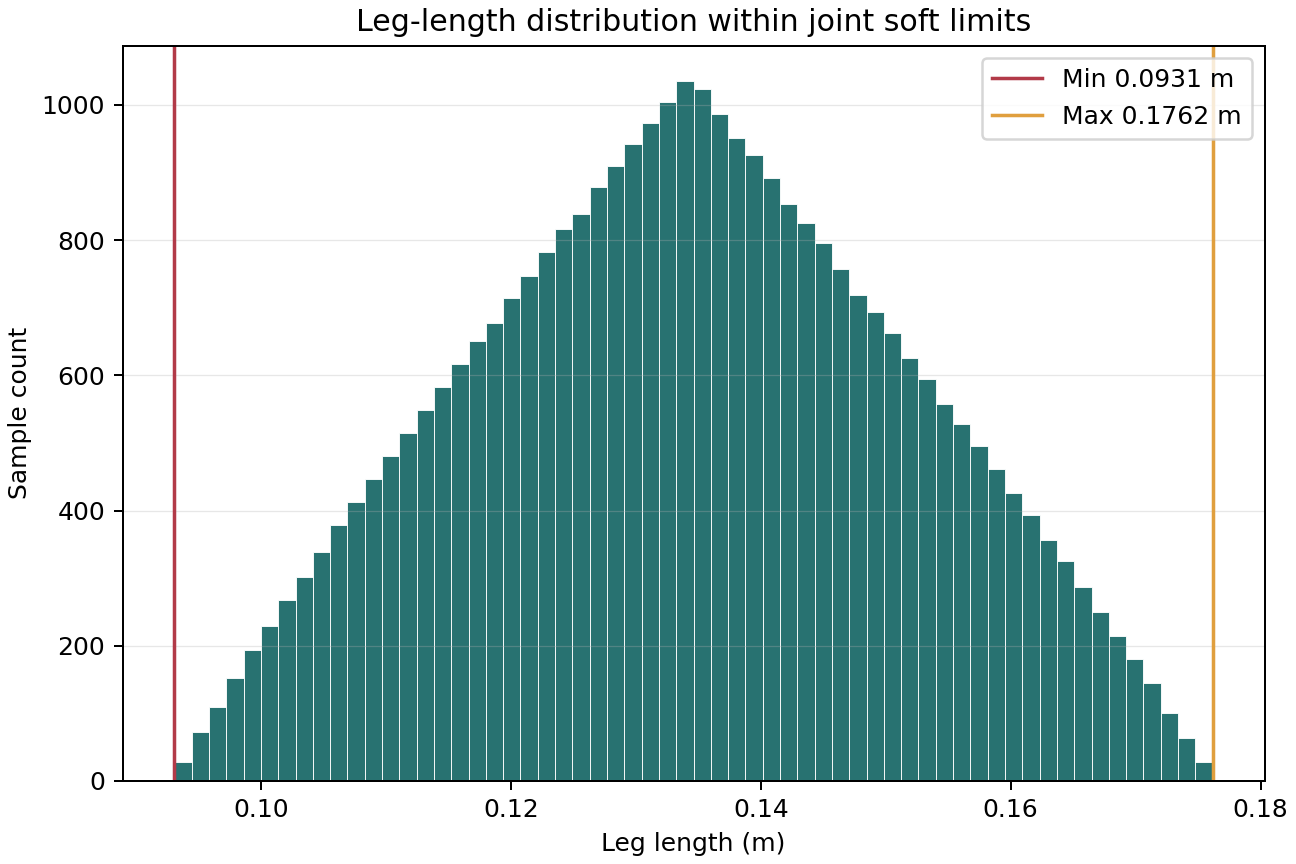
simulation/kinematics/single_leg/results/leg_length_range.png
