39394480ke-sys/serialstride-legbot/simulation/kinematics/single_leg/results/workspace_xz.png

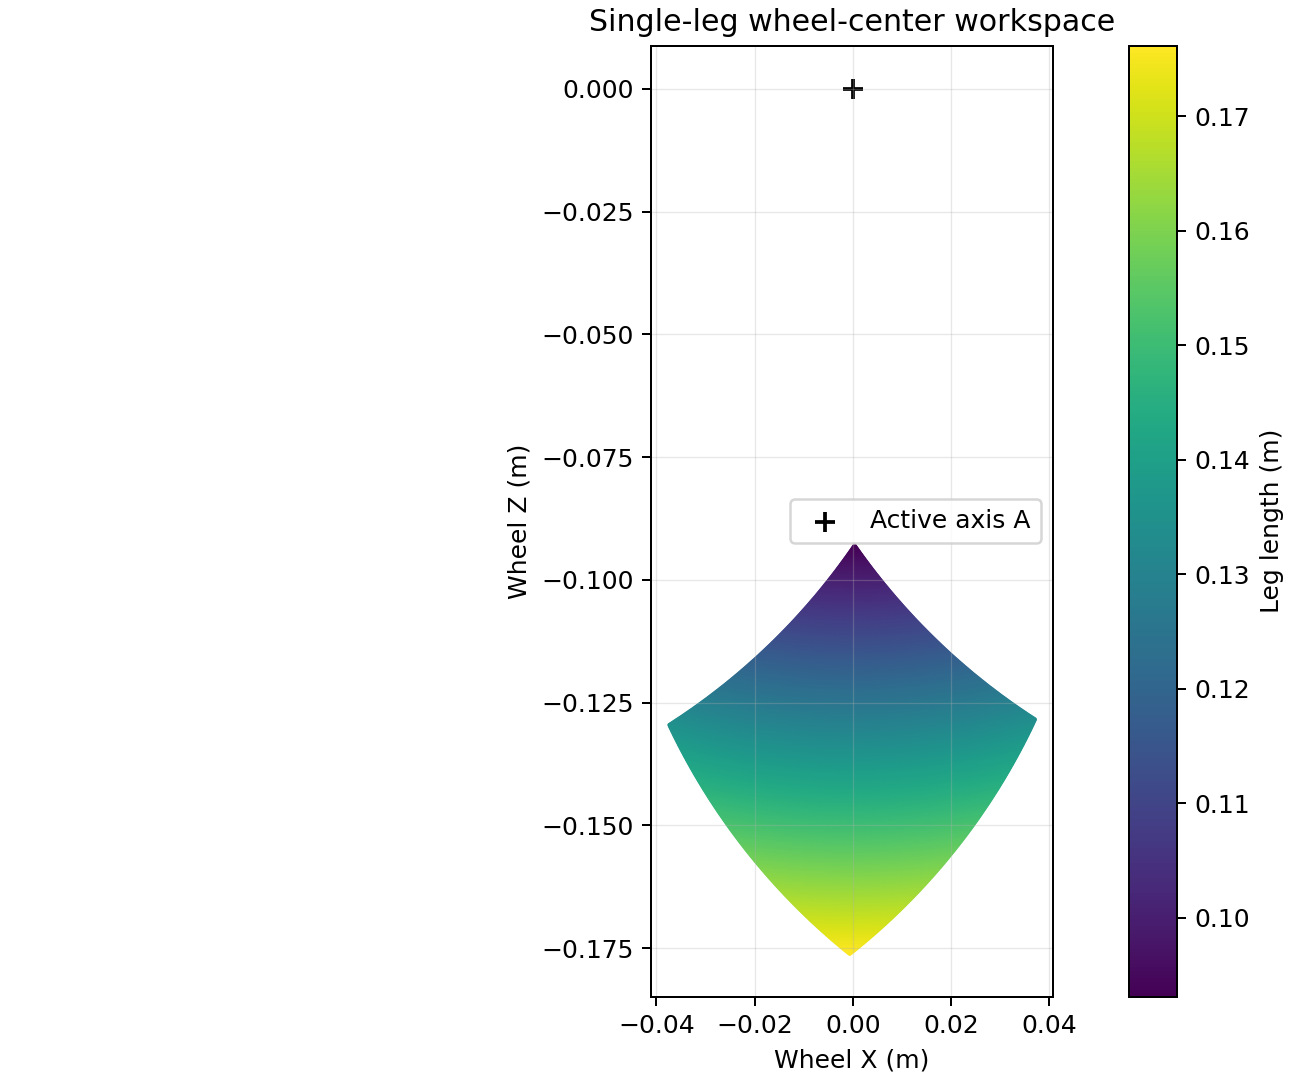
simulation/kinematics/single_leg/results/workspace_xz.png
