39394480ke-sys/serialstride-legbot/firmware/dm-mc02-can1-three-motor/tests/test_motion_controller.c

#include <assert.h>
#include <stdint.h>
#include <string.h>

#include "motion_controller.h"

static MotionSafetySnapshot safe_disabled_snapshot(uint32_t now_ms)
{
    return (MotionSafetySnapshot){
        .now_ms = now_ms,
        .feedback_age_ms = 0u,
        .parameter_mask = 0x1fu,
        .control_mode = 3u,
        .motor_state = 0u,
        .velocity_millirad_s = 0,
        .mos_temperature_c = 25u,
        .rotor_temperature_c = 25u,
        .feedback_valid = true,
        .can_warning = false,
        .can_passive = false,
        .can_bus_off = false,
    };
}

static MotionSafetySnapshot safe_enabled_snapshot(uint32_t now_ms)
{
    MotionSafetySnapshot safety = safe_disabled_snapshot(now_ms);

    safety.motor_state = 1u;
    return safety;
}

static MotionDecision arm_and_start(MotionController *controller,
                                    MotionSafetySnapshot *safety)
{
    MotionDecision decision;

    motion_controller_init(controller);
    decision = motion_controller_command(controller, 'A', safety);
    assert(decision.event == MOTION_EVENT_ARMED);
    return motion_controller_command(controller, 'G', safety);
}

static void assert_shutdown_after_next_millisecond(
    MotionController *controller, MotionSafetySnapshot safety)
{
    MotionDecision decision;

    safety.now_ms += 1u;
    decision = motion_controller_step(controller, &safety);
    assert(decision.action == MOTION_ACTION_DISABLE);
    assert(controller->state == MOTION_IDLE_DISABLED);
}

static void assert_enable_wait_trip(MotionSafetySnapshot startup,
                                    MotionSafetySnapshot safety,
                                    const char *expected_reason)
{
    MotionController controller;
    MotionDecision decision;

    assert(arm_and_start(&controller, &startup).action == MOTION_ACTION_ENABLE);
    decision = motion_controller_step(&controller, &safety);
    assert(decision.action == MOTION_ACTION_ZERO_VELOCITY);
    assert(decision.event == MOTION_EVENT_SAFETY_TRIP);
    assert(strcmp(decision.reason, expected_reason) == 0);
    assert(controller.state == MOTION_FAULT_DISABLE);
    assert_shutdown_after_next_millisecond(&controller, safety);
}

static void test_normalizes_commands_and_ignores_line_endings(void)
{
    MotionSafetySnapshot safety = safe_disabled_snapshot(1000u);
    MotionController controller;
    MotionDecision decision;

    motion_controller_init(&controller);
    decision = motion_controller_command(&controller, 's', &safety);
    assert(decision.event == MOTION_EVENT_STATUS);
    assert(controller.state == MOTION_IDLE_DISABLED);

    decision = motion_controller_command(&controller, '\r', &safety);
    assert(decision.action == MOTION_ACTION_NONE);
    assert(decision.event == MOTION_EVENT_NONE);
    decision = motion_controller_command(&controller, '\n', &safety);
    assert(decision.action == MOTION_ACTION_NONE);
    assert(decision.event == MOTION_EVENT_NONE);

    decision = motion_controller_command(&controller, 'a', &safety);
    assert(decision.event == MOTION_EVENT_ARMED);
    assert(controller.state == MOTION_ARMED);

    decision = motion_controller_command(&controller, 'g', &safety);
    assert(decision.action == MOTION_ACTION_ENABLE);
    assert(decision.event == MOTION_EVENT_START_REQUESTED);
    assert(controller.state == MOTION_ENABLE_WAIT);
    assert(!controller.armed);
}

static void test_rejects_start_without_a_fresh_arm(void)
{
    MotionSafetySnapshot safety = safe_disabled_snapshot(1000u);
    MotionController controller;
    MotionDecision decision;

    motion_controller_init(&controller);
    decision = motion_controller_command(&controller, 'G', &safety);
    assert(decision.action == MOTION_ACTION_NONE);
    assert(decision.event == MOTION_EVENT_START_REJECTED);
    assert(strcmp(decision.reason, "SEND_A_FIRST") == 0);
}

static void test_configurable_bringup_pulse_is_bounded(void)
{
    MotionSafetySnapshot safety = safe_disabled_snapshot(0u);
    MotionController controller;
    MotionDecision decision;

    motion_controller_init(&controller);
    assert(motion_controller_set_pulse_profile(&controller, 1, 300u));
    (void)motion_controller_command(&controller, 'A', &safety);
    decision = motion_controller_command(&controller, 'B', &safety);
    assert(decision.velocity_step == -1);
    safety = safe_enabled_snapshot(0u);
    (void)motion_controller_step(&controller, &safety);
    safety.now_ms = 300u;
    decision = motion_controller_step(&controller, &safety);
    assert(decision.event == MOTION_EVENT_ZERO_HOLD);
    assert(!motion_controller_set_pulse_profile(&controller, 1, 300u));
}

static void test_wheel_torque_limit_rejects_start_and_stops_runtime(void)
{
    MotionSafetySnapshot safety = safe_disabled_snapshot(0u);
    MotionController controller;
    MotionDecision decision;

    motion_controller_init(&controller);
    (void)motion_controller_command(&controller, 'A', &safety);
    safety.torque_millinewton_m = 501;
    decision = motion_controller_command(&controller, 'G', &safety);
    assert(decision.event == MOTION_EVENT_START_REJECTED);
    assert(strcmp(decision.reason, "TORQUE_LIMIT") == 0);

    safety.torque_millinewton_m = 0;
    motion_controller_init(&controller);
    (void)motion_controller_command(&controller, 'A', &safety);
    (void)motion_controller_command(&controller, 'G', &safety);
    safety = safe_enabled_snapshot(1u);
    (void)motion_controller_step(&controller, &safety);
    safety.now_ms = 2u;
    safety.torque_millinewton_m = -501;
    decision = motion_controller_step(&controller, &safety);
    assert(decision.event == MOTION_EVENT_SAFETY_TRIP);
    assert(strcmp(decision.reason, "TORQUE_LIMIT") == 0);
}

static void test_arm_boundary_and_one_shot_consumption(void)
{
    MotionSafetySnapshot safety = safe_disabled_snapshot(0u);
    MotionController controller;
    MotionDecision decision;

    motion_controller_init(&controller);
    assert(motion_controller_command(&controller, 'A', &safety).event ==
           MOTION_EVENT_ARMED);

    safety.now_ms = 9999u;
    decision = motion_controller_command(&controller, 'G', &safety);
    assert(decision.action == MOTION_ACTION_ENABLE);
    assert(!controller.armed);

    decision = motion_controller_command(&controller, 'G', &safety);
    assert(decision.event == MOTION_EVENT_START_REJECTED);
    assert(strcmp(decision.reason, "SEND_A_FIRST") == 0);

    motion_controller_init(&controller);
    safety.now_ms = 0u;
    assert(motion_controller_command(&controller, 'A', &safety).event ==
           MOTION_EVENT_ARMED);
    safety.now_ms = 10000u;
    decision = motion_controller_command(&controller, 'G', &safety);
    assert(decision.event == MOTION_EVENT_ARM_TIMEOUT);
    assert(strcmp(decision.reason, "ARM_TIMEOUT") == 0);
    assert(controller.state == MOTION_IDLE_DISABLED);
}

static void test_arm_timeout_handles_tick_wraparound(void)
{
    MotionSafetySnapshot safety = safe_disabled_snapshot(UINT32_MAX - 5000u);
    MotionController controller;
    MotionDecision decision;

    motion_controller_init(&controller);
    assert(motion_controller_command(&controller, 'A', &safety).event ==
           MOTION_EVENT_ARMED);

    safety.now_ms = 4998u;
    decision = motion_controller_command(&controller, 'G', &safety);
    assert(decision.action == MOTION_ACTION_ENABLE);

    motion_controller_init(&controller);
    safety.now_ms = UINT32_MAX - 5000u;
    assert(motion_controller_command(&controller, 'A', &safety).event ==
           MOTION_EVENT_ARMED);
    safety.now_ms = 4999u;
    decision = motion_controller_command(&controller, 'G', &safety);
    assert(decision.event == MOTION_EVENT_ARM_TIMEOUT);
}

static void assert_start_rejected_for_unsafe_snapshot(
    MotionSafetySnapshot safety, const char *expected_reason)
{
    MotionController controller;
    MotionDecision decision;

    motion_controller_init(&controller);
    assert(motion_controller_command(&controller, 'A', &safety).event ==
           MOTION_EVENT_ARMED);
    decision = motion_controller_command(&controller, 'G', &safety);
    assert(decision.action == MOTION_ACTION_NONE);
    assert(decision.event == MOTION_EVENT_START_REJECTED);
    assert(strcmp(decision.reason, expected_reason) == 0);
    assert(controller.state == MOTION_ARMED);
}

static void test_rejects_each_unsafe_start_condition(void)
{
    MotionSafetySnapshot safety = safe_disabled_snapshot(100u);

    safety.parameter_mask = 0x0fu;
    assert_start_rejected_for_unsafe_snapshot(safety, "PARAMETERS_INCOMPLETE");
    safety = safe_disabled_snapshot(100u);
    safety.control_mode = 2u;
    assert_start_rejected_for_unsafe_snapshot(safety, "MODE_NOT_VELOCITY");
    safety = safe_disabled_snapshot(100u);
    safety.feedback_valid = false;
    assert_start_rejected_for_unsafe_snapshot(safety, "FEEDBACK_STALE");
    safety = safe_disabled_snapshot(100u);
    safety.feedback_age_ms = 501u;
    assert_start_rejected_for_unsafe_snapshot(safety, "FEEDBACK_STALE");
    safety = safe_disabled_snapshot(100u);
    safety.motor_state = 1u;
    assert_start_rejected_for_unsafe_snapshot(safety, "STATE_NOT_DISABLED");
    safety = safe_disabled_snapshot(100u);
    safety.velocity_millirad_s = 100;
    assert_start_rejected_for_unsafe_snapshot(safety, "SPEED_NOT_ZERO");
    safety = safe_disabled_snapshot(100u);
    safety.velocity_millirad_s = -100;
    assert_start_rejected_for_unsafe_snapshot(safety, "SPEED_NOT_ZERO");
    safety = safe_disabled_snapshot(100u);
    safety.mos_temperature_c = 60u;
    assert_start_rejected_for_unsafe_snapshot(safety, "TEMPERATURE_LIMIT");
    safety = safe_disabled_snapshot(100u);
    safety.rotor_temperature_c = 60u;
    assert_start_rejected_for_unsafe_snapshot(safety, "TEMPERATURE_LIMIT");
    safety = safe_disabled_snapshot(100u);
    safety.can_warning = true;
    assert_start_rejected_for_unsafe_snapshot(safety, "CAN_NOT_ACTIVE");
    safety = safe_disabled_snapshot(100u);
    safety.can_passive = true;
    assert_start_rejected_for_unsafe_snapshot(safety, "CAN_NOT_ACTIVE");
    safety = safe_disabled_snapshot(100u);
    safety.can_bus_off = true;
    assert_start_rejected_for_unsafe_snapshot(safety, "CAN_NOT_ACTIVE");
}

static void test_emergency_stop_requests_zero_from_every_state(void)
{
    static const MotionState states[] = {
        MOTION_IDLE_DISABLED,
        MOTION_ARMED,
        MOTION_ENABLE_WAIT,
        MOTION_RUNNING,
        MOTION_ZERO_HOLD,
        MOTION_DISABLE_WAIT,
        MOTION_FAULT_ZERO,
        MOTION_FAULT_DISABLE,
    };
    MotionSafetySnapshot safety = safe_disabled_snapshot(100u);

    for (uint8_t index = 0u; index < sizeof(states) / sizeof(states[0]); ++index) {
        MotionController controller;
        MotionDecision decision;

        motion_controller_init(&controller);
        controller.state = states[index];
        controller.armed = true;
        controller.last_action_ms = 100u;
        decision = motion_controller_command(&controller, 'x', &safety);
        assert(decision.action == MOTION_ACTION_ZERO_VELOCITY);
        assert(decision.event == MOTION_EVENT_EMERGENCY_STOP);
        assert(!controller.armed);
        assert(controller.state == MOTION_FAULT_DISABLE);
        assert_shutdown_after_next_millisecond(&controller, safety);
    }
}

static void test_enable_wait_graces_start_eligible_stale_feedback(void)
{
    static const uint32_t accepted_feedback_ages_ms[] = {101u, 500u};

    for (uint8_t index = 0u;
         index < sizeof(accepted_feedback_ages_ms) /
                     sizeof(accepted_feedback_ages_ms[0]);
         ++index) {
        MotionSafetySnapshot safety = safe_disabled_snapshot(1000u);
        MotionController controller;
        MotionDecision decision;

        safety.feedback_age_ms = accepted_feedback_ages_ms[index];
        decision = arm_and_start(&controller, &safety);
        assert(decision.action == MOTION_ACTION_ENABLE);
        assert(controller.state == MOTION_ENABLE_WAIT);

        decision = motion_controller_step(&controller, &safety);
        assert(decision.action == MOTION_ACTION_NONE);
        assert(decision.event == MOTION_EVENT_NONE);
        assert(controller.state == MOTION_ENABLE_WAIT);

        safety.now_ms = 1099u;
        safety.feedback_age_ms += 99u;
        decision = motion_controller_step(&controller, &safety);
        assert(decision.action == MOTION_ACTION_NONE);
        assert(decision.event == MOTION_EVENT_NONE);
        assert(controller.state == MOTION_ENABLE_WAIT);
    }
}

static void test_enable_wait_starts_on_fresh_safe_enabled_feedback(void)
{
    MotionSafetySnapshot safety = safe_disabled_snapshot(1000u);
    MotionController controller;
    MotionDecision decision;

    safety.feedback_age_ms = 500u;
    assert(arm_and_start(&controller, &safety).action == MOTION_ACTION_ENABLE);
    assert(motion_controller_step(&controller, &safety).action ==
           MOTION_ACTION_NONE);

    safety = safe_enabled_snapshot(1050u);
    decision = motion_controller_step(&controller, &safety);
    assert(decision.action == MOTION_ACTION_POSITIVE_VELOCITY);
    assert(decision.event == MOTION_EVENT_RUNNING);
    assert(controller.state == MOTION_RUNNING);
}

static void test_enable_wait_deadline_requires_fresh_enabled_feedback(void)
{
    MotionSafetySnapshot startup = safe_disabled_snapshot(1000u);
    MotionSafetySnapshot safety = safe_disabled_snapshot(1100u);

    startup.feedback_age_ms = 101u;
    safety.feedback_age_ms = 201u;
    assert_enable_wait_trip(startup, safety, "FEEDBACK_STALE");

    startup = safe_disabled_snapshot(1000u);
    safety = safe_disabled_snapshot(1100u);
    assert_enable_wait_trip(startup, safety, "STATE_NOT_ENABLED");

    startup = safe_disabled_snapshot(1000u);
    safety = safe_enabled_snapshot(1101u);
    assert_enable_wait_trip(startup, safety, "STATE_NOT_ENABLED");
}

static void test_enable_wait_trips_on_fresh_unsafe_feedback_during_grace(void)
{
    MotionSafetySnapshot startup = safe_disabled_snapshot(1000u);
    MotionSafetySnapshot safety = safe_disabled_snapshot(1050u);

    safety.velocity_millirad_s = 801;
    assert_enable_wait_trip(startup, safety, "SPEED_LIMIT");

    safety = safe_disabled_snapshot(1050u);
    safety.mos_temperature_c = 60u;
    assert_enable_wait_trip(startup, safety, "TEMPERATURE_LIMIT");

    safety = safe_disabled_snapshot(1050u);
    safety.motor_state = 8u;
    assert_enable_wait_trip(startup, safety, "STATE_NOT_ENABLED");
}

static void test_enable_wait_trips_on_can_fault_with_stale_feedback(void)
{
    MotionSafetySnapshot startup = safe_disabled_snapshot(1000u);
    MotionSafetySnapshot safety;

    startup.feedback_age_ms = 101u;
    safety = startup;
    safety.can_passive = true;
    assert_enable_wait_trip(startup, safety, "CAN_NOT_ACTIVE");

    safety = startup;
    safety.can_bus_off = true;
    assert_enable_wait_trip(startup, safety, "CAN_NOT_ACTIVE");
}

static void test_runs_the_fixed_positive_timeline(void)
{
    MotionSafetySnapshot safety = safe_disabled_snapshot(0u);
    MotionController controller;
    MotionDecision decision;
    uint32_t now_ms;

    decision = arm_and_start(&controller, &safety);
    assert(decision.action == MOTION_ACTION_ENABLE);
    assert(controller.state == MOTION_ENABLE_WAIT);

    safety = safe_enabled_snapshot(100u);
    decision = motion_controller_step(&controller, &safety);
    assert(decision.action == MOTION_ACTION_POSITIVE_VELOCITY);
    assert(decision.event == MOTION_EVENT_RUNNING);
    assert(controller.state == MOTION_RUNNING);

    for (now_ms = 110u; now_ms <= 1090u; now_ms += 10u) {
        safety.now_ms = now_ms;
        decision = motion_controller_step(&controller, &safety);
        assert(decision.action == MOTION_ACTION_POSITIVE_VELOCITY);
        assert(controller.state == MOTION_RUNNING);
    }

    safety.now_ms = 1100u;
    decision = motion_controller_step(&controller, &safety);
    assert(decision.action == MOTION_ACTION_ZERO_VELOCITY);
    assert(decision.event == MOTION_EVENT_ZERO_HOLD);
    assert(controller.state == MOTION_ZERO_HOLD);

    for (now_ms = 1110u; now_ms <= 1290u; now_ms += 10u) {
        safety.now_ms = now_ms;
        decision = motion_controller_step(&controller, &safety);
        assert(decision.action == MOTION_ACTION_ZERO_VELOCITY);
        assert(controller.state == MOTION_ZERO_HOLD);
    }

    safety.now_ms = 1300u;
    decision = motion_controller_step(&controller, &safety);
    assert(decision.action == MOTION_ACTION_DISABLE);
    assert(decision.event == MOTION_EVENT_DISABLE_REQUESTED);
    assert(controller.state == MOTION_DISABLE_WAIT);

    safety.now_ms = 1301u;
    decision = motion_controller_step(&controller, &safety);
    assert(decision.action == MOTION_ACTION_NONE);
    assert(decision.event == MOTION_EVENT_NONE);
    assert(controller.state == MOTION_DISABLE_WAIT);

    safety.now_ms = 1302u;
    safety.motor_state = 0u;
    decision = motion_controller_step(&controller, &safety);
    assert(decision.action == MOTION_ACTION_NONE);
    assert(decision.event == MOTION_EVENT_COMPLETE);
    assert(controller.state == MOTION_IDLE_DISABLED);
}

static void test_disable_confirmation_timeout_fails_closed(void)
{
    MotionController controller = {
        .state = MOTION_DISABLE_WAIT,
        .phase_started_ms = 100u,
    };
    MotionSafetySnapshot safety = safe_enabled_snapshot(300u);
    MotionDecision decision = motion_controller_step(&controller, &safety);

    assert(decision.action == MOTION_ACTION_ZERO_VELOCITY);
    assert(decision.event == MOTION_EVENT_SAFETY_TRIP);
    assert(strcmp(decision.reason, "DISABLE_TIMEOUT") == 0);
}

static void assert_runtime_trip(MotionSafetySnapshot safety,
                                const char *expected_reason)
{
    MotionController controller;
    MotionDecision decision;
    MotionSafetySnapshot startup = safe_disabled_snapshot(0u);

    assert(arm_and_start(&controller, &startup).action ==
           MOTION_ACTION_ENABLE);
    startup = safe_enabled_snapshot(100u);
    assert(motion_controller_step(&controller, &startup).action ==
           MOTION_ACTION_POSITIVE_VELOCITY);
    safety.now_ms = 110u;
    decision = motion_controller_step(&controller, &safety);
    assert(decision.action == MOTION_ACTION_ZERO_VELOCITY);
    assert(decision.event == MOTION_EVENT_SAFETY_TRIP);
    assert(strcmp(decision.reason, expected_reason) == 0);
    assert(controller.state == MOTION_FAULT_DISABLE);
    assert_shutdown_after_next_millisecond(&controller, safety);
}

static void test_runtime_safety_trips_zero_then_disable(void)
{
    MotionSafetySnapshot safety = safe_enabled_snapshot(110u);

    safety.feedback_age_ms = 101u;
    assert_runtime_trip(safety, "FEEDBACK_STALE");
    safety = safe_enabled_snapshot(110u);
    safety.velocity_millirad_s = 801;
    assert_runtime_trip(safety, "SPEED_LIMIT");
    safety = safe_enabled_snapshot(110u);
    safety.mos_temperature_c = 60u;
    assert_runtime_trip(safety, "TEMPERATURE_LIMIT");
    safety = safe_enabled_snapshot(110u);
    safety.rotor_temperature_c = 60u;
    assert_runtime_trip(safety, "TEMPERATURE_LIMIT");
    safety = safe_enabled_snapshot(110u);
    safety.motor_state = 0u;
    assert_runtime_trip(safety, "STATE_NOT_ENABLED");
    safety = safe_enabled_snapshot(110u);
    safety.can_passive = true;
    assert_runtime_trip(safety, "CAN_NOT_ACTIVE");
    safety = safe_enabled_snapshot(110u);
    safety.can_bus_off = true;
    assert_runtime_trip(safety, "CAN_NOT_ACTIVE");
}

static void test_transmit_failure_requests_zero_then_disable(void)
{
    MotionController controller;
    MotionSafetySnapshot safety = safe_disabled_snapshot(0u);
    MotionDecision decision;

    assert(arm_and_start(&controller, &safety).action == MOTION_ACTION_ENABLE);
    safety = safe_enabled_snapshot(100u);
    assert(motion_controller_step(&controller, &safety).action ==
           MOTION_ACTION_POSITIVE_VELOCITY);
    decision = motion_controller_tx_failed(&controller);
    assert(decision.action == MOTION_ACTION_ZERO_VELOCITY);
    assert(decision.event == MOTION_EVENT_TX_FAILURE);
    assert(controller.state == MOTION_FAULT_DISABLE);
    assert_shutdown_after_next_millisecond(&controller, safety);
}

static void test_failed_zero_command_immediately_falls_back_to_disable(void)
{
    MotionController controller;
    MotionSafetySnapshot safety = safe_disabled_snapshot(100u);
    MotionDecision decision;

    motion_controller_init(&controller);
    assert(motion_controller_command(&controller, 'X', &safety).action ==
           MOTION_ACTION_ZERO_VELOCITY);
    decision = motion_controller_tx_failed(&controller);
    assert(decision.action == MOTION_ACTION_DISABLE);
    assert(decision.event == MOTION_EVENT_TX_FAILURE);
    assert(controller.state == MOTION_IDLE_DISABLED);
}

static void test_negative_pulse_uses_negative_two_step(void)
{
    MotionController controller;
    MotionSafetySnapshot safety = safe_disabled_snapshot(0u);
    MotionDecision decision;

    motion_controller_init(&controller);
    assert(motion_controller_command(&controller, 'A', &safety).event ==
           MOTION_EVENT_ARMED);
    decision = motion_controller_command(&controller, 'B', &safety);
    assert(decision.action == MOTION_ACTION_ENABLE);
    assert(decision.velocity_step == -2);
    safety = safe_enabled_snapshot(50u);
    decision = motion_controller_step(&controller, &safety);
    assert(decision.event == MOTION_EVENT_RUNNING);
    assert(decision.velocity_step == -2);
}

static void test_continuous_ramp_clamp_keepalive_and_watchdog(void)
{
    MotionController controller;
    MotionSafetySnapshot safety = safe_disabled_snapshot(0u);
    MotionDecision decision;
    int index;

    motion_controller_init(&controller);
    (void)motion_controller_command(&controller, 'A', &safety);
    assert(motion_controller_command(&controller, 'C', &safety).action ==
           MOTION_ACTION_ENABLE);
    safety = safe_enabled_snapshot(50u);
    decision = motion_controller_step(&controller, &safety);
    assert(decision.event == MOTION_EVENT_CONTINUOUS_READY);
    assert(decision.velocity_step == 0);

    safety.now_ms = 60u;
    for (index = 0; index < 6; ++index)
        decision = motion_controller_command(&controller, '+', &safety);
    assert(decision.event == MOTION_EVENT_TARGET_UPDATED);
    assert(controller.target_step == 5);
    safety.now_ms = 150u;
    decision = motion_controller_step(&controller, &safety);
    assert(decision.action == MOTION_ACTION_VELOCITY);
    assert(decision.velocity_step == 1);

    safety.now_ms = 200u;
    decision = motion_controller_command(&controller, 'K', &safety);
    assert(decision.event == MOTION_EVENT_KEEPALIVE);
    safety.now_ms = 5199u;
    assert(motion_controller_step(&controller, &safety).event !=
           MOTION_EVENT_HOST_WATCHDOG);
    safety.now_ms = 5200u;
    decision = motion_controller_step(&controller, &safety);
    assert(decision.event == MOTION_EVENT_HOST_WATCHDOG);
    assert(controller.state == MOTION_WATCHDOG_RAMP);

    safety.now_ms = 5300u;
    decision = motion_controller_step(&controller, &safety);
    assert(decision.action == MOTION_ACTION_VELOCITY);
    assert(decision.velocity_step == 1);
    safety.now_ms = 5400u;
    decision = motion_controller_step(&controller, &safety);
    assert(decision.action == MOTION_ACTION_VELOCITY);
    assert(decision.velocity_step == 0);
    safety.now_ms = 5401u;
    decision = motion_controller_step(&controller, &safety);
    assert(decision.event == MOTION_EVENT_ZERO_HOLD);
    safety.now_ms = 5601u;
    decision = motion_controller_step(&controller, &safety);
    assert(decision.action == MOTION_ACTION_DISABLE);
    assert(decision.event == MOTION_EVENT_DISABLE_REQUESTED);
    assert(strcmp(decision.reason, "HOST_WATCHDOG") == 0);
    safety.now_ms = 5602u;
    safety.motor_state = 0u;
    decision = motion_controller_step(&controller, &safety);
    assert(decision.event == MOTION_EVENT_COMPLETE);
}

static void test_continuous_runtime_safety_still_fails_closed(void)
{
    MotionController controller;
    MotionSafetySnapshot safety = safe_disabled_snapshot(0u);
    MotionDecision decision;

    motion_controller_init(&controller);
    (void)motion_controller_command(&controller, 'A', &safety);
    (void)motion_controller_command(&controller, 'C', &safety);
    safety = safe_enabled_snapshot(50u);
    (void)motion_controller_step(&controller, &safety);
    safety.now_ms = 51u;
    safety.mos_temperature_c = 60u;
    decision = motion_controller_step(&controller, &safety);
    assert(decision.action == MOTION_ACTION_VELOCITY);
    assert(decision.velocity_step == 0);
    assert(decision.event == MOTION_EVENT_SAFETY_TRIP);
}

int main(void)
{
    test_normalizes_commands_and_ignores_line_endings();
    test_rejects_start_without_a_fresh_arm();
    test_configurable_bringup_pulse_is_bounded();
    test_wheel_torque_limit_rejects_start_and_stops_runtime();
    test_arm_boundary_and_one_shot_consumption();
    test_arm_timeout_handles_tick_wraparound();
    test_rejects_each_unsafe_start_condition();
    test_emergency_stop_requests_zero_from_every_state();
    test_enable_wait_graces_start_eligible_stale_feedback();
    test_enable_wait_starts_on_fresh_safe_enabled_feedback();
    test_enable_wait_deadline_requires_fresh_enabled_feedback();
    test_enable_wait_trips_on_fresh_unsafe_feedback_during_grace();
    test_enable_wait_trips_on_can_fault_with_stale_feedback();
    test_runs_the_fixed_positive_timeline();
    test_disable_confirmation_timeout_fails_closed();
    test_runtime_safety_trips_zero_then_disable();
    test_transmit_failure_requests_zero_then_disable();
    test_failed_zero_command_immediately_falls_back_to_disable();
    test_negative_pulse_uses_negative_two_step();
    test_continuous_ramp_clamp_keepalive_and_watchdog();
    test_continuous_runtime_safety_still_fails_closed();
    return 0;
}
