39394480ke-sys/serialstride-legbot/firmware/dm-mc02-can1-three-motor/tests/test_dm4310_controller.c

#include <assert.h>
#include <string.h>

#include "dm4310_controller.h"

static Dm4310SafetySnapshot safe_snapshot(uint32_t now_ms)
{
    Dm4310SafetySnapshot safety = {
        .now_ms = now_ms,
        .feedback_age_ms = 0u,
        .motor_state = 0u,
        .powered = true,
        .probe_active = true,
        .parameters_valid = true,
        .feedback_valid = true,
    };

    return safety;
}

static void test_arm_and_short_pulse_sequence(void)
{
    Dm4310Controller controller;
    Dm4310SafetySnapshot safety = safe_snapshot(0u);
    Dm4310MotionDecision result;

    dm4310_controller_init(&controller);
    result = dm4310_controller_command(&controller, 'A', &safety);
    assert(result.event == DM4310_EVENT_ARMED);

    safety.now_ms = 1u;
    result = dm4310_controller_command(&controller, 'G', &safety);
    assert(result.send_enable && result.target_velocity_millirad_s == 400);
    assert(controller.state == DM4310_MOTION_ENABLE_WAIT);

    safety.now_ms = 101u;
    safety.motor_state = 1u;
    result = dm4310_controller_step(&controller, &safety);
    assert(result.event == DM4310_EVENT_RUNNING && result.send_mit);

    safety.now_ms = 2101u;
    result = dm4310_controller_step(&controller, &safety);
    assert(result.event == DM4310_EVENT_ZERO_HOLD && result.send_mit);
    assert(result.target_velocity_millirad_s == 0);
    assert(controller.target_velocity_millirad_s == 0);

    safety.now_ms = 2301u;
    result = dm4310_controller_step(&controller, &safety);
    assert(result.event == DM4310_EVENT_DISABLE_REQUESTED &&
           result.send_disable);
    assert(controller.state == DM4310_MOTION_DISABLE_WAIT);

    safety.now_ms = 2400u;
    result = dm4310_controller_step(&controller, &safety);
    assert(result.event == DM4310_EVENT_NONE);
    assert(controller.state == DM4310_MOTION_DISABLE_WAIT);

    safety.now_ms = 2401u;
    safety.motor_state = 0u;
    result = dm4310_controller_step(&controller, &safety);
    assert(result.event == DM4310_EVENT_COMPLETE && !result.cut_power);
    assert(controller.state == DM4310_MOTION_DISABLED);
}

static void test_disable_confirmation_timeout_fails_closed(void)
{
    Dm4310Controller controller = {
        .state = DM4310_MOTION_DISABLE_WAIT,
        .phase_started_ms = 100u,
    };
    Dm4310SafetySnapshot safety = safe_snapshot(300u);
    Dm4310MotionDecision result;

    safety.motor_state = 1u;
    result = dm4310_controller_step(&controller, &safety);
    assert(result.event == DM4310_EVENT_SAFETY_TRIP);
    assert(strcmp(result.reason, "DISABLE_TIMEOUT") == 0);
    assert(result.send_mit && result.send_disable && result.cut_power);
}

static void test_configurable_bringup_pulse_is_bounded(void)
{
    Dm4310Controller controller;
    Dm4310SafetySnapshot safety = safe_snapshot(0u);
    Dm4310MotionDecision result;

    dm4310_controller_init(&controller);
    assert(dm4310_controller_set_pulse_profile(&controller, 50, 300u));
    (void)dm4310_controller_command(&controller, 'A', &safety);
    result = dm4310_controller_command(&controller, 'B', &safety);
    assert(result.target_velocity_millirad_s == -50);
    safety.motor_state = 1u;
    (void)dm4310_controller_step(&controller, &safety);
    safety.now_ms = 300u;
    result = dm4310_controller_step(&controller, &safety);
    assert(result.event == DM4310_EVENT_ZERO_HOLD && result.send_mit);
    assert(!dm4310_controller_set_pulse_profile(&controller, 50, 300u));
}

static void test_zero_speed_test_remains_500_ms(void)
{
    Dm4310Controller controller;
    Dm4310SafetySnapshot safety = safe_snapshot(0u);
    Dm4310MotionDecision result;

    dm4310_controller_init(&controller);
    (void)dm4310_controller_command(&controller, 'A', &safety);
    safety.now_ms = 1u;
    (void)dm4310_controller_command(&controller, 'N', &safety);
    safety.now_ms = 2u;
    safety.motor_state = 1u;
    (void)dm4310_controller_step(&controller, &safety);
    safety.now_ms = 502u;
    result = dm4310_controller_step(&controller, &safety);
    assert(result.event == DM4310_EVENT_ZERO_HOLD && result.send_mit);
}

static void test_enable_deadline_fails_closed(void)
{
    Dm4310Controller controller;
    Dm4310SafetySnapshot safety = safe_snapshot(10u);
    Dm4310MotionDecision result;

    dm4310_controller_init(&controller);
    (void)dm4310_controller_command(&controller, 'A', &safety);
    safety.now_ms = 11u;
    (void)dm4310_controller_command(&controller, 'N', &safety);

    safety.now_ms = 112u;
    safety.motor_state = 1u;
    result = dm4310_controller_step(&controller, &safety);
    assert(result.event == DM4310_EVENT_SAFETY_TRIP);
    assert(result.send_mit && result.send_disable && result.cut_power);
    assert(strcmp(result.reason, "ENABLE_TIMEOUT") == 0);
}

static void test_start_guards(void)
{
    Dm4310Controller controller;
    Dm4310SafetySnapshot safety = safe_snapshot(0u);
    Dm4310MotionDecision result;

    dm4310_controller_init(&controller);
    (void)dm4310_controller_command(&controller, 'A', &safety);
    safety.parameters_valid = false;
    result = dm4310_controller_command(&controller, 'B', &safety);
    assert(result.event == DM4310_EVENT_REJECTED);
    assert(strcmp(result.reason, "PARAMETERS_MISMATCH") == 0);

    safety.parameters_valid = true;
    safety.velocity_millirad_s = 100;
    result = dm4310_controller_command(&controller, 'B', &safety);
    assert(strcmp(result.reason, "SPEED_NOT_ZERO") == 0);
}

static void test_runtime_guards_and_emergency(void)
{
    Dm4310Controller controller;
    Dm4310SafetySnapshot safety = safe_snapshot(0u);
    Dm4310MotionDecision result;

    dm4310_controller_init(&controller);
    (void)dm4310_controller_command(&controller, 'A', &safety);
    safety.now_ms = 1u;
    (void)dm4310_controller_command(&controller, 'G', &safety);
    safety.now_ms = 2u;
    safety.motor_state = 1u;
    (void)dm4310_controller_step(&controller, &safety);

    safety.now_ms = 12u;
    safety.torque_millinewton_m = 501;
    result = dm4310_controller_step(&controller, &safety);
    assert(result.cut_power && result.send_mit && result.send_disable);
    assert(strcmp(result.reason, "TORQUE_LIMIT") == 0);

    dm4310_controller_init(&controller);
    result = dm4310_controller_command(&controller, 'X', &safety);
    assert(result.event == DM4310_EVENT_EMERGENCY_STOP);
    assert(result.cut_power && result.send_mit && result.send_disable);

    result = dm4310_controller_tx_failed(&controller);
    assert(result.event == DM4310_EVENT_TX_FAILURE && result.cut_power);
}

int main(void)
{
    test_arm_and_short_pulse_sequence();
    test_disable_confirmation_timeout_fails_closed();
    test_configurable_bringup_pulse_is_bounded();
    test_zero_speed_test_remains_500_ms();
    test_enable_deadline_fails_closed();
    test_start_guards();
    test_runtime_guards_and_emergency();
    return 0;
}
