39394480ke-sys/serialstride-legbot/(commit log)

2026-07-29 chore: archive verified H6215 single-motor bring-up
2026-08-08 feat: encode guarded H6215 motion frames
2026-08-08 fix: retain H6215 recovery and queue motion logs
    [main.c, test_motion_io.c]
2026-08-08 fix: drop rejected CDC log records
    [main.c, test_motion_io.c]
2026-08-08 fix: align H6215 telemetry cadence with motion state
    [main.c, test_motion_io.c]
2026-08-08 fix: keep H6215 idle feedback fresh
    [main.c, test_motion_io.c]
2026-08-08 fix: honor H6215 enable feedback grace
    [motion_controller.c, test_motion_controller.c]
2026-08-08 fix: harden guarded motion safety paths
    [board.c, main.c, test_feedback_timing.c, test_usb_command_queue.c]
2026-08-09 feat: add guarded MC02 motor power checkpoint
2026-08-09 feat: add guarded DM4310 joint A bring-up
2026-08-09 fix: raise joint A damping for unloaded startup
    [dm4310_controller.c, test_dm4310_controller.c]
2026-08-09 fix: extend joint A motion pulses for visibility
    [dm4310_controller.c, dm4310_controller.h, test_dm4310_controller.c]
2026-08-09 tune: make joint A direction pulses visible
2026-08-09 feat: switch guarded bring-up to joint B
2026-08-09 feat: add three-motor CAN1 read-only bring-up
2026-08-09 feat: add guarded three-motor sequential validation
2026-08-09 feat: add guarded three-motor parallel validation
2026-08-09 refactor: split three-motor firmware architecture
2026-08-09 docs: archive MC02 three-motor CAN1 bring-up
2026-08-10 feat(firmware): add guarded single-leg mechanical bring-up
2026-08-10 docs: archive v0.2.0 single-leg bring-up
2026-08-13 feat(simulation): add single-leg forward kinematics model
    [calibration.yaml, reference_poses.csv]
2026-08-13 feat(simulation): add full-chassis MuJoCo geometric model
    [base_link.stl, link_002.stl, link_003.stl, link_004.stl, link_005.stl, link_006.stl, link_007.stl, link_008.stl]
2026-08-13 docs: archive kinematics and MuJoCo modeling stage
2026-08-14 refactor(simulation): separate MuJoCo model responsibilities
    [body_mass_map.csv, com_comparison.csv, joint_limits.yaml, joint_scan.csv, modal_scan.csv, robot_dynamics.xml, robot_geometry.xml]
2026-08-15 feat(simulation): add full-chassis basic dynamics baseline
    [com_comparison.csv, drop_test.xml, fixed_base.xml, free_ground.xml, joint_limits.yaml, modal_scan.csv]
2026-08-15 docs: archive full-chassis basic dynamics stage
